jhonatasmoraes/Projeto_TCC_Git/readme.md

Neste projeto será colocado as informações do programa construído para o meu projeto de TCC.

26/02/23 Criação dos arquivos no Git    

-> A
