jhonatasmoraes/Projeto_TCC_Git/Placas/baterias/placa.pdf

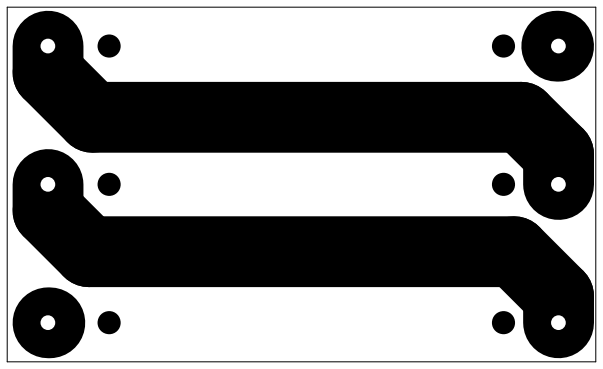
[picture p1: figure]
