jhonatasmoraes/Projeto_TCC_Git/Placas/Base/Chassi2.stl

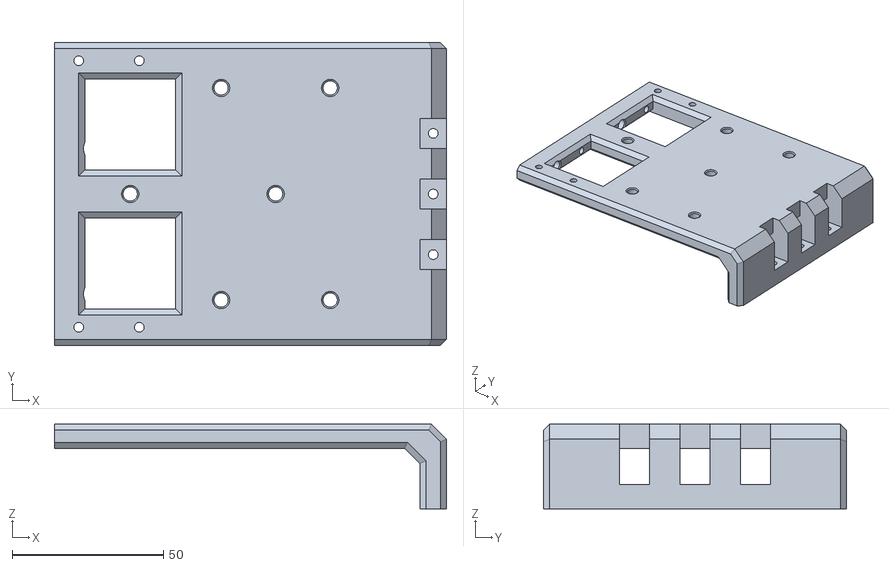
[picture p2: CAD file, 2023-05-03]
Placas/Base/Chassi2.stl
129.4 x 100.0 x 28.0
