jhonatasmoraes/Projeto_TCC_Git/Placas/baterias/baterias.step

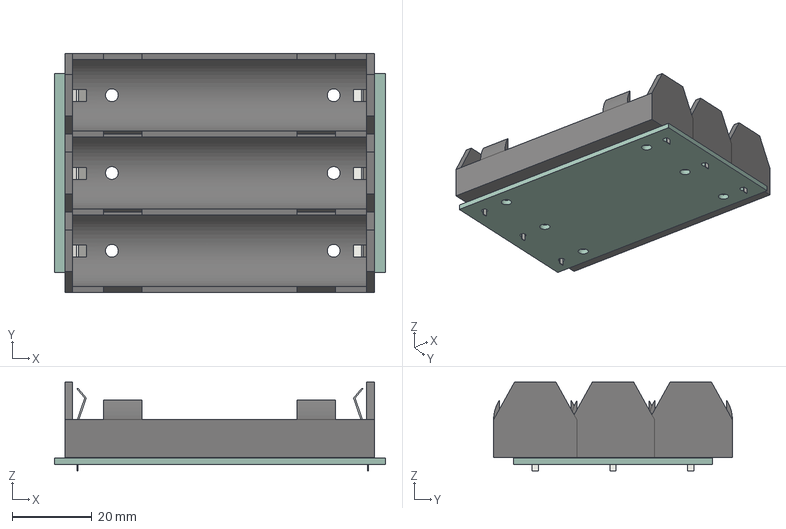
[picture p3: CAD file, 2023-05-03]
Placas/baterias/baterias.step
83.0 x 59.9 x 22.2 mm
baterias PCB
