jhonatasmoraes/Projeto_TCC_Git/Placas/Botoes/botoes/Botao.stl

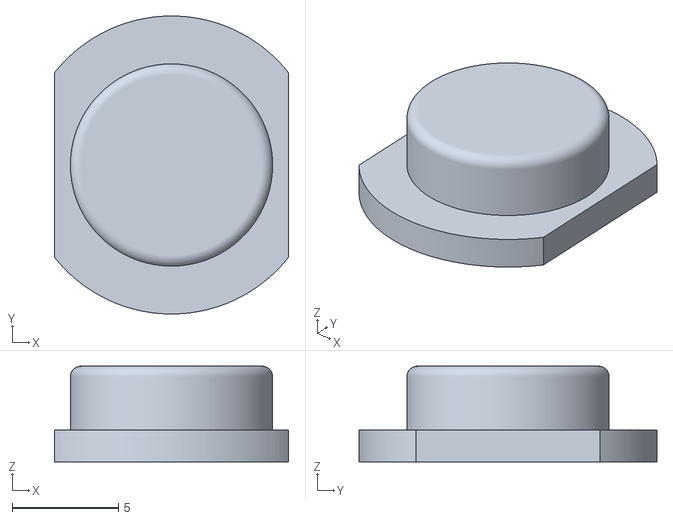
[picture p4: CAD file, 2023-05-03]
Placas/Botoes/botoes/Botao.stl
11.0 x 14.0 x 4.50
