jhonatasmoraes/Projeto_TCC_Git/tampabaseplacas.stl

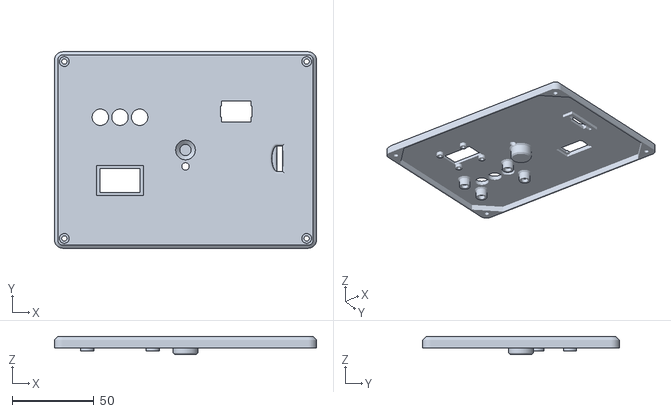
[picture p5: CAD file, 2023-05-03]
tampabaseplacas.stl
160.0 x 120.0 x 11.0
