jhonatasmoraes/Projeto_TCC_Git/ParteFora.stl

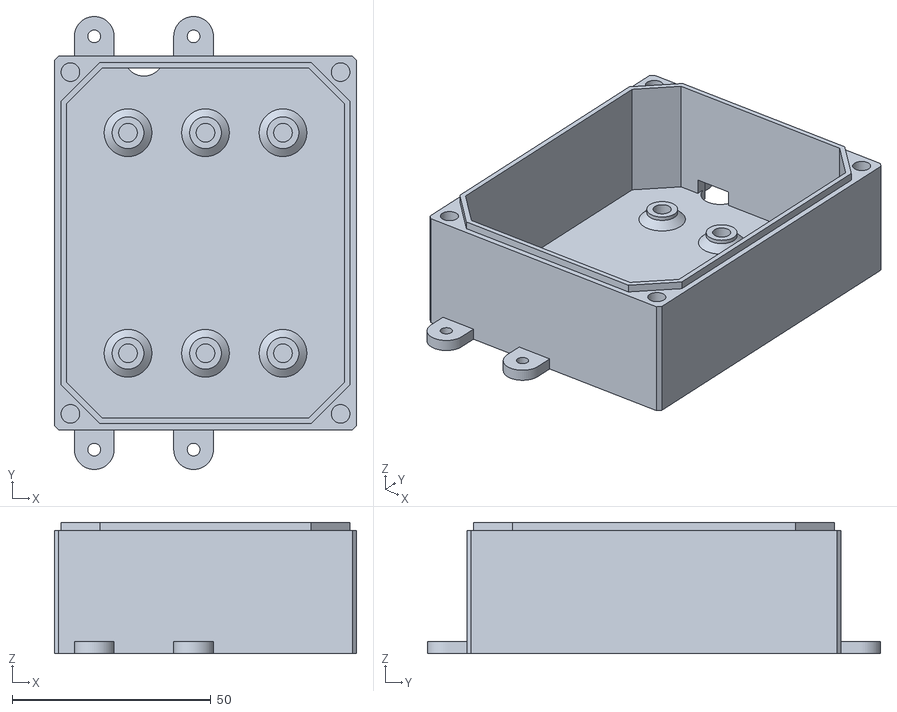
[picture p6: CAD file, 2023-05-03]
ParteFora.stl
76.0 x 114.0 x 33.0
