jhonatasmoraes/Projeto_TCC_Git/Placas/Base/testeinsert.stl

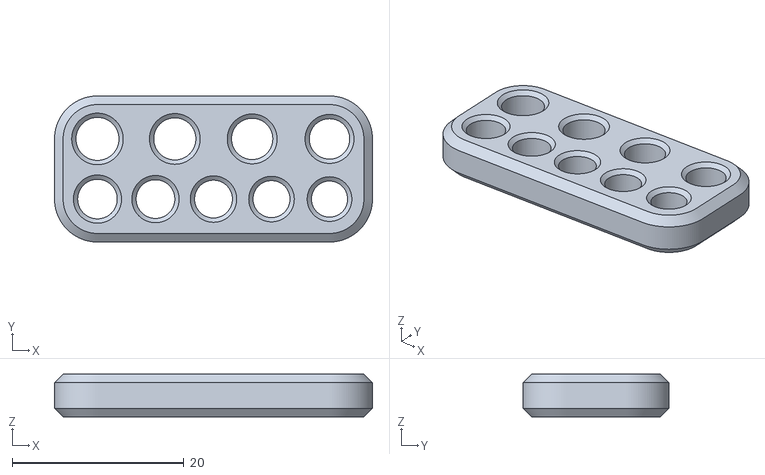
[picture p7: CAD file, 2023-05-03]
Placas/Base/testeinsert.stl
37.0 x 17.0 x 5.00
