jhonatasmoraes/Projeto_TCC_Git/Placas/Botoes/botoes/botoes.step

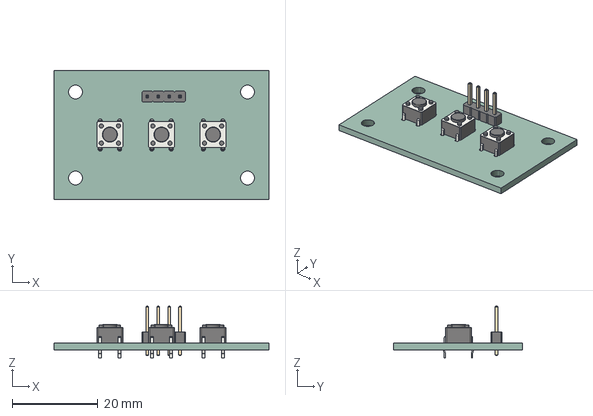
[picture p8: CAD file, 2023-05-03]
Placas/Botoes/botoes/botoes.step
50.0 x 30.0 x 12.0 mm
_autosave-botoes PCB
