jhonatasmoraes/Projeto_TCC_Git/TampaBateria.stl

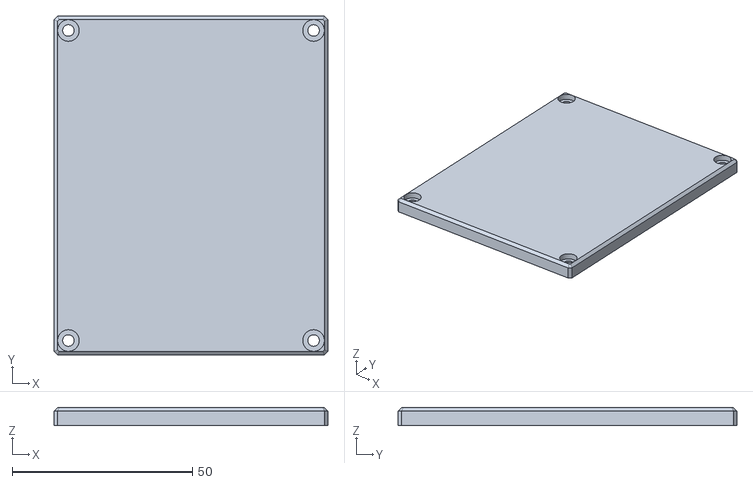
[picture p9: CAD file, 2023-05-03]
TampaBateria.stl
76.0 x 94.0 x 5.00
