jhonatasmoraes/Projeto_TCC_Git/tampa garrafa.stl

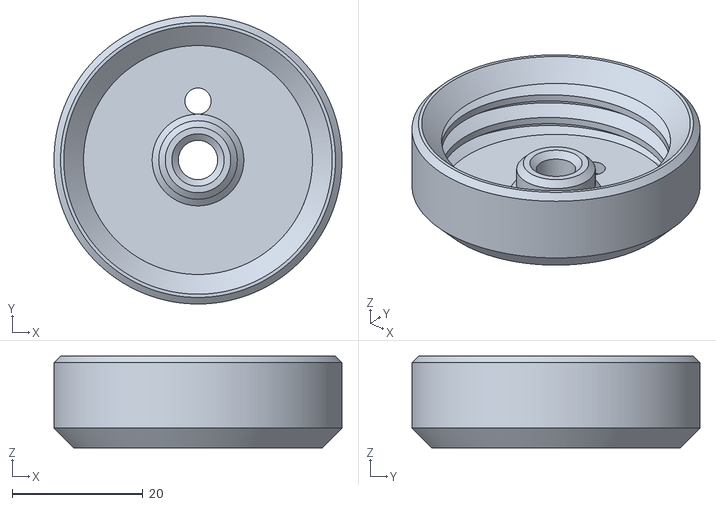
[picture p10: CAD file, 2023-05-03]
tampa garrafa.stl
44.0 x 44.0 x 14.0
