jhonatasmoraes/Projeto_TCC_Git/TravaSuperior.stl

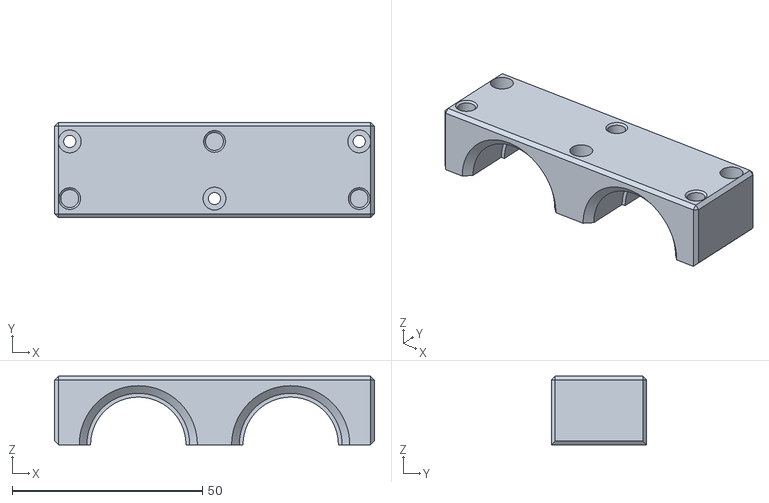
[picture p11: CAD file, 2023-05-03]
TravaSuperior.stl
84.0 x 25.0 x 18.0
