jhonatasmoraes/Projeto_TCC_Git/suporte garrafa.stl

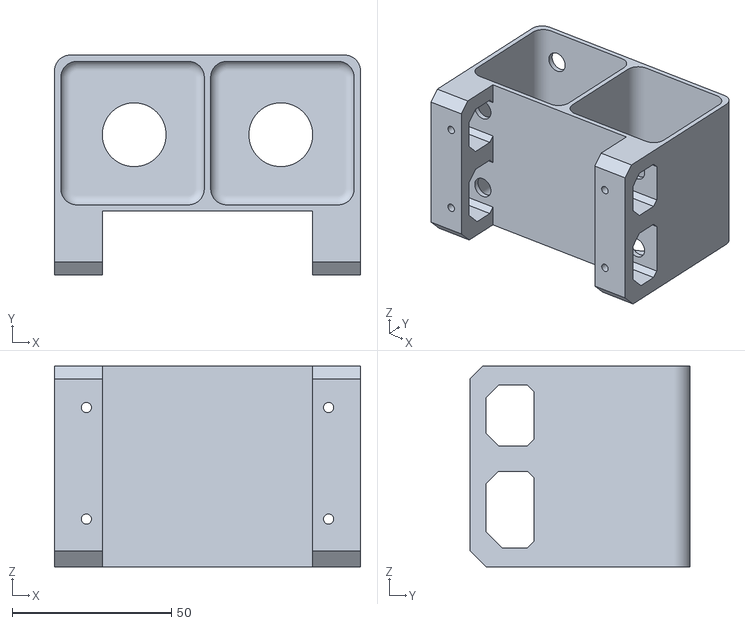
[picture p12: CAD file, 2023-05-03]
suporte garrafa.stl
96.0 x 69.0 x 63.0
