jhonatasmoraes/Projeto_TCC_Git/BombasBase.stl

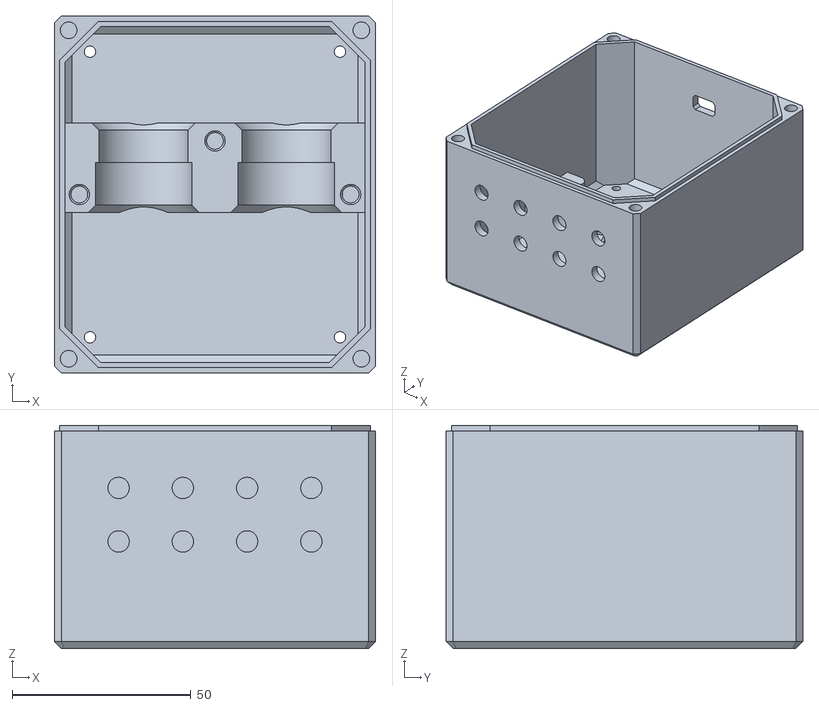
[picture p13: CAD file, 2023-05-03]
BombasBase.stl
90.0 x 100.0 x 62.5
