jhonatasmoraes/Projeto_TCC_Git/botao.stl

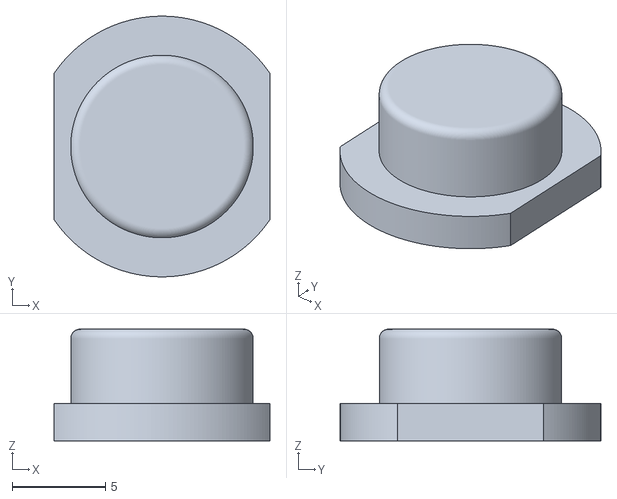
[picture p14: CAD file, 2023-05-03]
botao.stl
11.6 x 14.0 x 6.00
