jhonatasmoraes/Projeto_TCC_Git/Corpo1.stl

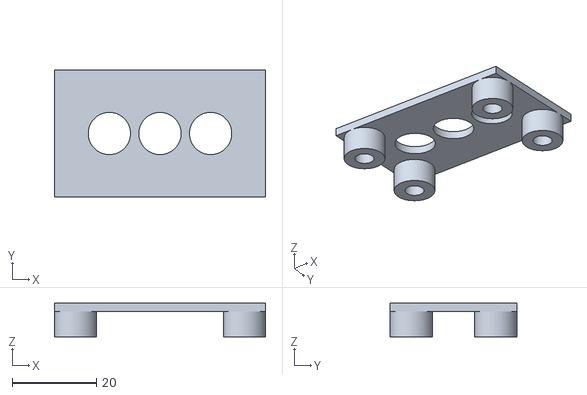
[picture p15: CAD file, 2023-05-03]
Corpo1.stl
50.0 x 30.0 x 8.00
