jhonatasmoraes/Projeto_TCC_Git/BaseBombas.stl

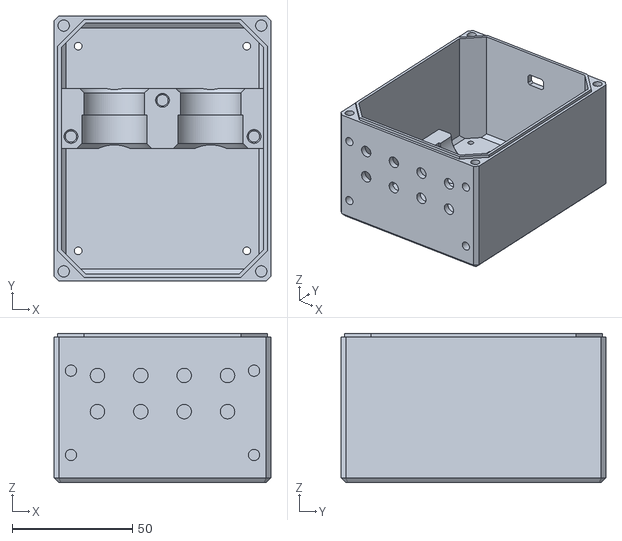
[picture p16: CAD file, 2023-05-03]
BaseBombas.stl
90.0 x 110.0 x 62.0
