jhonatasmoraes/Projeto_TCC_Git/BombasTampa.stl

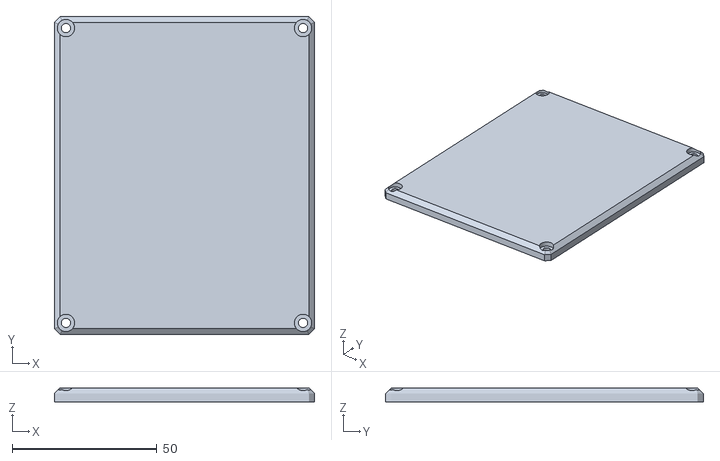
[picture p17: CAD file, 2023-05-03]
BombasTampa.stl
90.0 x 110.0 x 5.00
