jhonatasmoraes/Projeto_TCC_Git/cASEbASE.stl

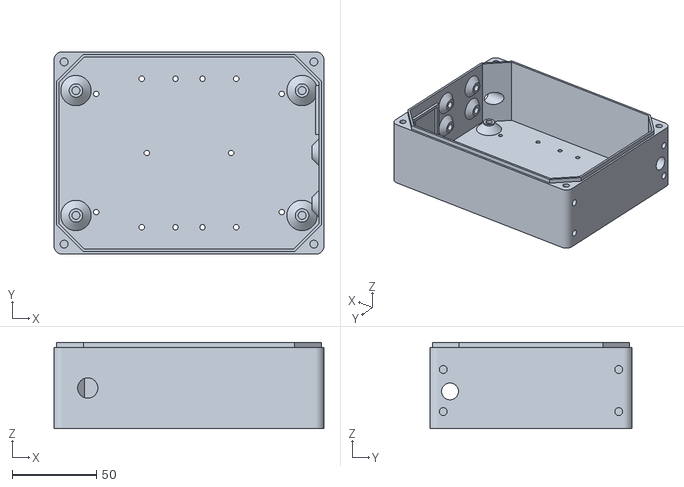
[picture p18: CAD file, 2023-05-03]
cASEbASE.stl
160.0 x 120.0 x 51.0
