jhonatasmoraes/Projeto_TCC_Git/SuportePinoColeta.stl

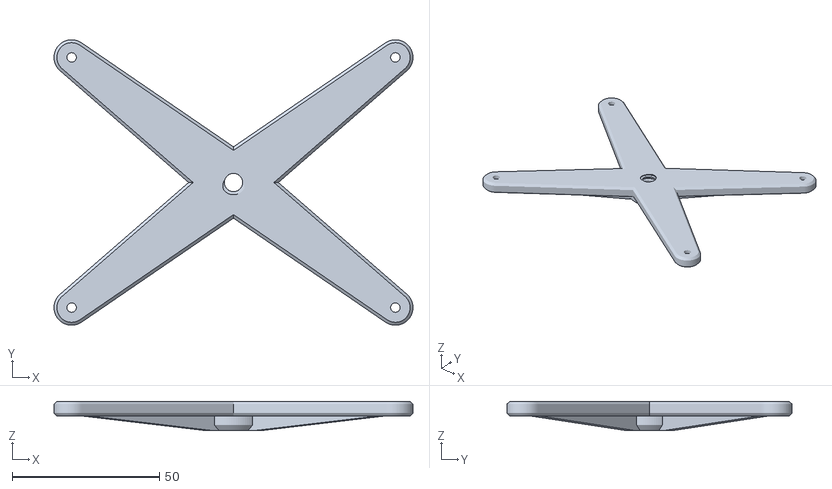
[picture p19: CAD file, 2023-05-03]
SuportePinoColeta.stl
122.0 x 97.0 x 10.0
