jhonatasmoraes/Projeto_TCC_Git/testerosca.stl

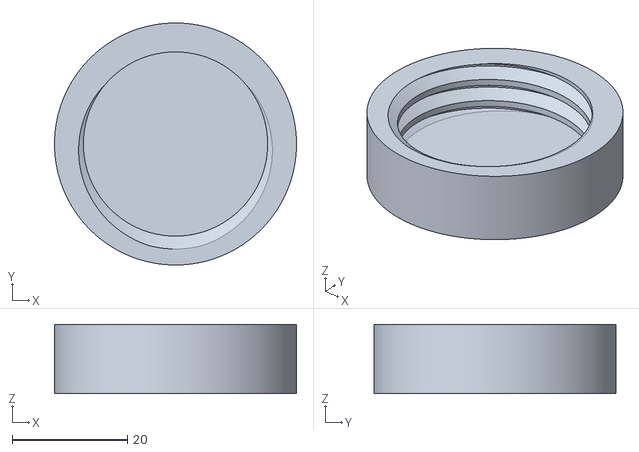
[picture p20: CAD file, 2023-05-03]
testerosca.stl
42.0 x 42.0 x 12.0
