jhonatasmoraes/Projeto_TCC_Git/TravaCentral.stl

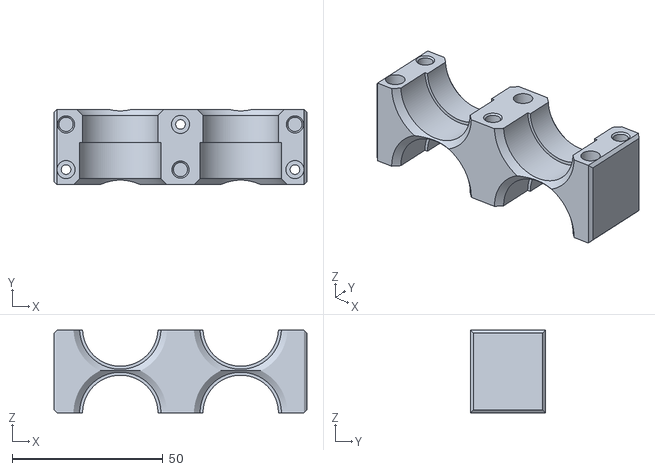
[picture p21: CAD file, 2023-05-03]
TravaCentral.stl
84.0 x 25.0 x 27.5
