jhonatasmoraes/Projeto_TCC_Git/tampateste.stl

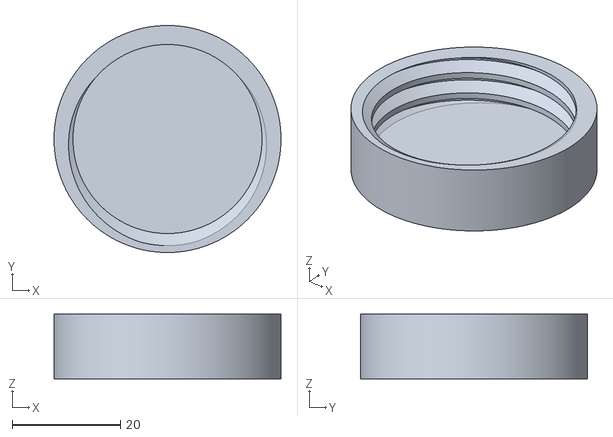
[picture p22: CAD file, 2023-05-03]
tampateste.stl
42.0 x 42.0 x 12.0
