jhonatasmoraes/Projeto_TCC_Git/Emenda.stl

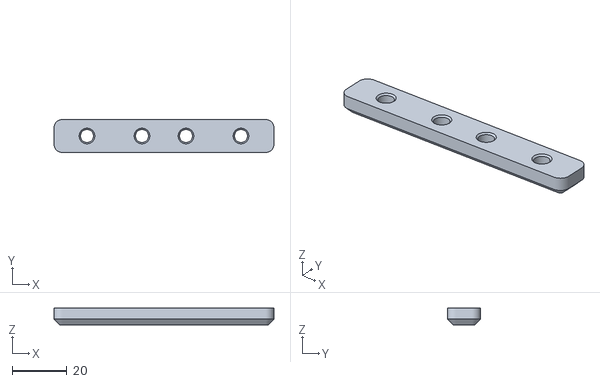
[picture p23: CAD file, 2023-05-03]
Emenda.stl
80.0 x 12.0 x 6.00
