jhonatasmoraes/Projeto_TCC_Git/pinocoleta.stl

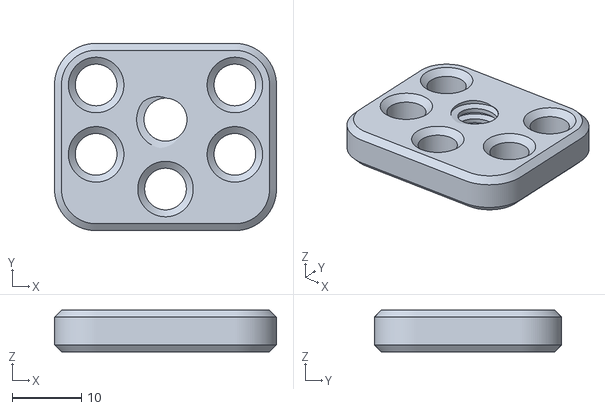
[picture p24: CAD file, 2023-05-03]
pinocoleta.stl
32.0 x 27.0 x 6.00
