jhonatasmoraes/Projeto_TCC_Git/(list of files, cad)

Other CAD files:
tampa.stl
