jhonatasmoraes/Projeto_TCC_Git/Placas/Base/NjczMTEzOTgtMTAz.pdf

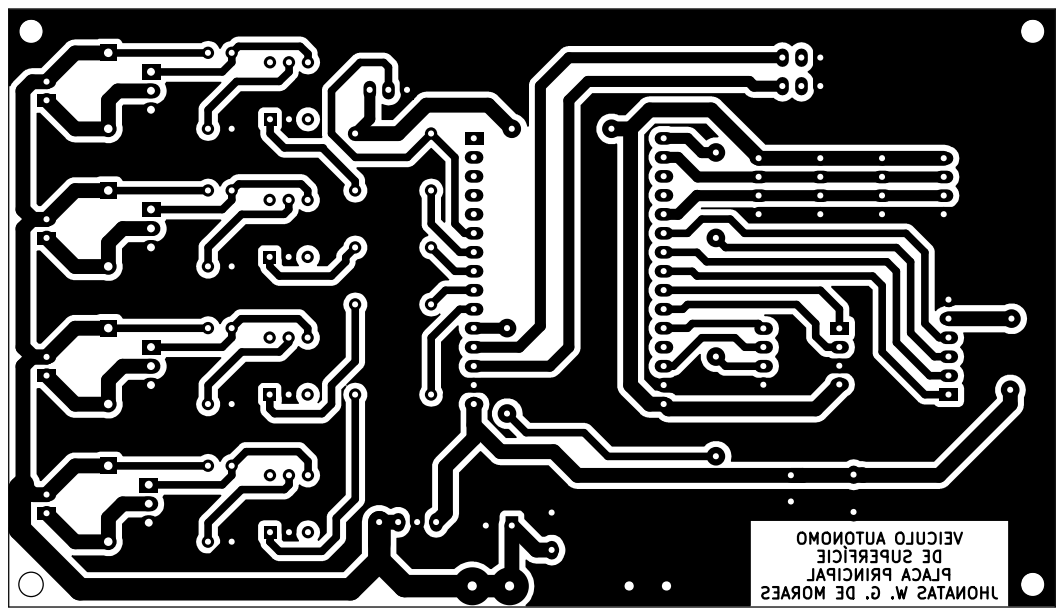
[picture p25: page 1]
