jhonatasmoraes/Projeto_TCC_Git/Placas/Botoes/botoes/asdasdd.pdf

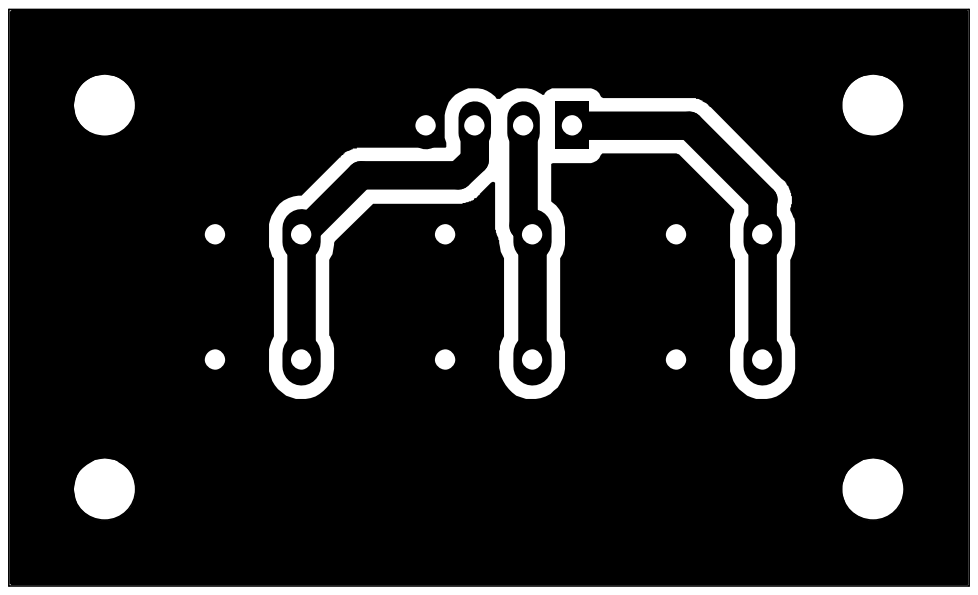
[picture p26: page 1]
