jhonatasmoraes/Projeto_TCC_Git/Placas/Base/Base.kicad_pcb

## KiCad design Placas/Base/Base.kicad_pcb (2023-05-03)

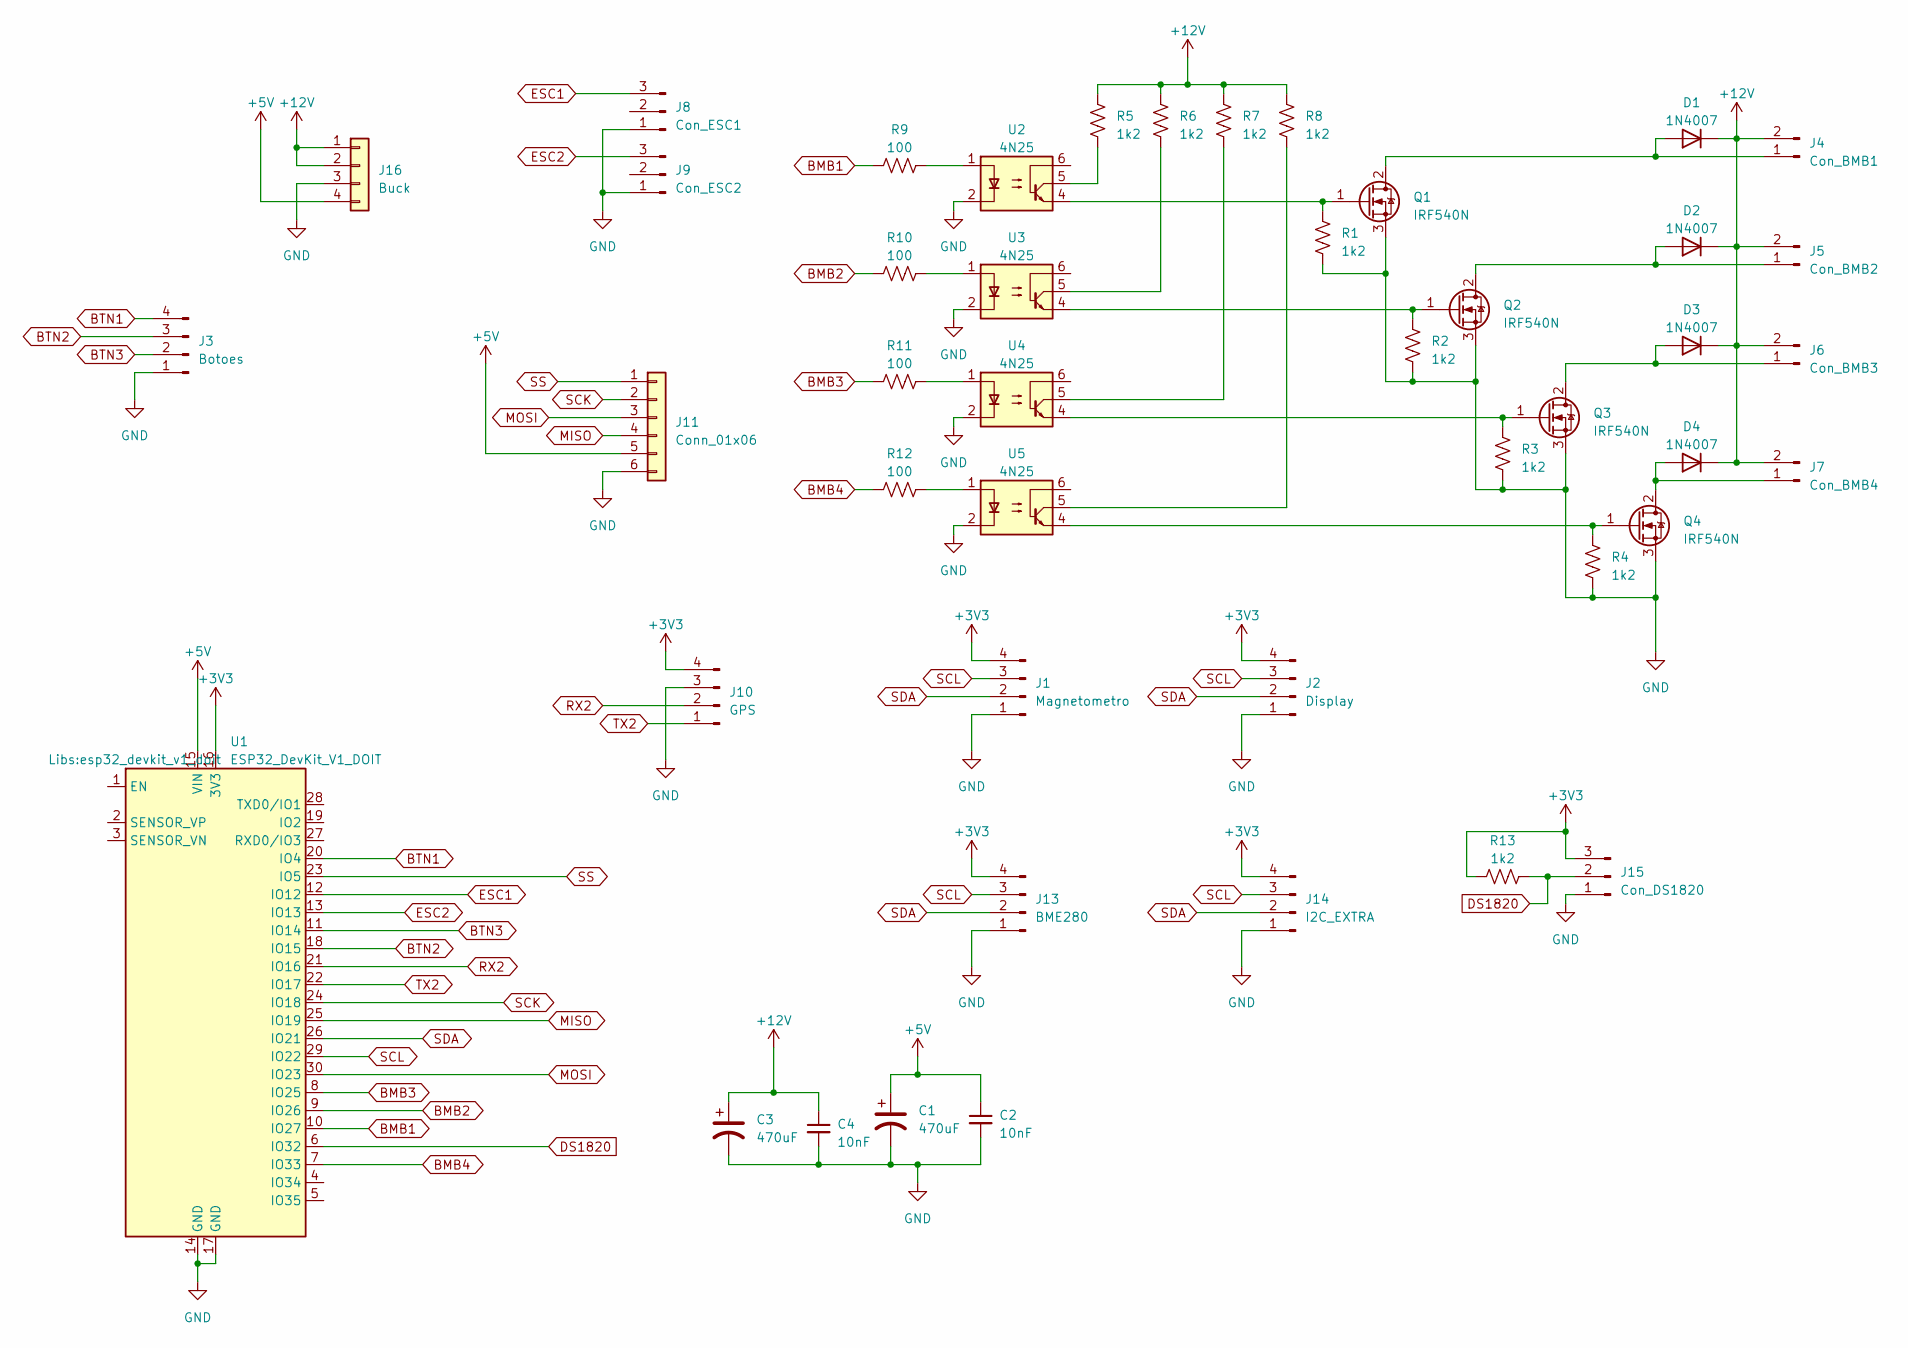
[picture p27: schematic Base.kicad_sch]

Parts:
C1, C3: 470uF; CP_Radial_D8.0mm_P3.50mm
C2, C4: 10nF; C_Disc_D7.0mm_W2.5mm_P5.00mm
D1, D2, D3, D4: 1N4007; D_DO-41_SOD81_P10.16mm_Horizontal
J1: Magnetometro; JST_XH_B4B-XH-A_1x04_P2.50mm_Vertical
J2: Display; JST_XH_B4B-XH-A_1x04_P2.50mm_Vertical
J3: Botoes; JST_XH_B4B-XH-A_1x04_P2.50mm_Vertical
J4: Con_BMB1; JST_XH_B2B-XH-A_1x02_P2.50mm_Vertical
J5: Con_BMB2; JST_XH_B2B-XH-A_1x02_P2.50mm_Vertical
J6: Con_BMB3; JST_XH_B2B-XH-A_1x02_P2.50mm_Vertical
J7: Con_BMB4; JST_XH_B2B-XH-A_1x02_P2.50mm_Vertical
J8: Con_ESC1; PinHeader_1x03_P2.54mm_Vertical
J9: Con_ESC2; PinHeader_1x03_P2.54mm_Vertical
J10: GPS; JST_XH_B4B-XH-A_1x04_P2.50mm_Vertical
J11: Conn_01x06; PinHeader_1x06_P2.54mm_Vertical
J13: BME280; JST_XH_B4B-XH-A_1x04_P2.50mm_Vertical
J14: I2C_EXTRA; JST_XH_B4B-XH-A_1x04_P2.50mm_Vertical
J15: Con_DS1820; JST_XH_B3B-XH-A_1x03_P2.50mm_Vertical
J16: Buck; PinHeader_1x04_P2.54mm_Horizontal
Q1, Q2, Q3, Q4: IRF540N; TO-220-3_Vertical
R1, R2, R3, R4, R5, R6, R7, R8, R13: 1k2; R_Axial_DIN0207_L6.3mm_D2.5mm_P10.16mm_Horizontal
R9, R10, R11, R12: 100; R_Axial_DIN0207_L6.3mm_D2.5mm_P10.16mm_Horizontal
U1: ESP32_DevKit_V1_DOIT; esp32_devkit_v1_doit
U2, U3, U4, U5: 4N25; DIP-6_W7.62mm

Connections:
+3V3: J1.4, J2.4, J10.4, J13.4, J14.4, J15.3, R13.1, U1.16 (3V3)
+5V: C1.1, C2.1, J11.5, J16.4, U1.15 (VIN)
+12V: C3.1, C4.1, D1.1 (K), D2.1 (K), D3.1 (K), D4.1 (K), J4.2, J5.2, J6.2, J7.2, J16.1, J16.2, R5.1, R6.1, R7.1, R8.1
BMB1: R9.1, U1.10 (IO27)
BMB2: R10.1, U1.9 (IO26)
BMB3: R11.1, U1.8 (IO25)
BMB4: R12.1, U1.7 (IO33)
BTN1: J3.4, U1.20 (IO4)
BTN2: J3.3, U1.18 (IO15)
BTN3: J3.2, U1.11 (IO14)
DS1820: J15.2, R13.2, U1.6 (IO32)
ESC1: J8.3, U1.12 (IO12)
ESC2: J9.3, U1.13 (IO13)
GND: C1.2, C2.2, C3.2, C4.2, J1.1, J2.1, J3.1, J8.1, J9.1, J10.3, J11.6, J13.1, J14.1, J15.1, J16.3, Q1.3 (S), Q2.3 (S), Q3.3 (S), Q4.3 (S), R1.2, R2.2, R3.2, R4.2, U1.14 (GND), U1.17 (GND), U2.2, U3.2, U4.2, U5.2
MISO: J11.4, U1.25 (IO19)
MOSI: J11.3, U1.30 (IO23)
unnamed: D1.2 (A), J4.1, Q1.2 (D)
unnamed: D2.2 (A), J5.1, Q2.2 (D)
unnamed: D3.2 (A), J6.1, Q3.2 (D)
unnamed: D4.2 (A), J7.1, Q4.2 (D)
unnamed: Q1.1 (G), R1.1, U2.4
unnamed: Q2.1 (G), R2.1, U3.4
unnamed: Q3.1 (G), R3.1, U4.4
unnamed: Q4.1 (G), R4.1, U5.4
unnamed: R5.2, U2.5
unnamed: R6.2, U3.5
unnamed: R7.2, U4.5
unnamed: R8.2, U5.5
unnamed: R9.2, U2.1
unnamed: R10.2, U3.1
unnamed: R11.2, U4.1
unnamed: R12.2, U5.1
RX2: J10.2, U1.21 (IO16)
SCK: J11.2, U1.24 (IO18)
SCL: J1.3, J2.3, J13.3, J14.3, U1.29 (IO22)
SDA: J1.2, J2.2, J13.2, J14.2, U1.26 (IO21)
SS: J11.1, U1.23 (IO5)
TX2: J10.1, U1.22 (IO17)

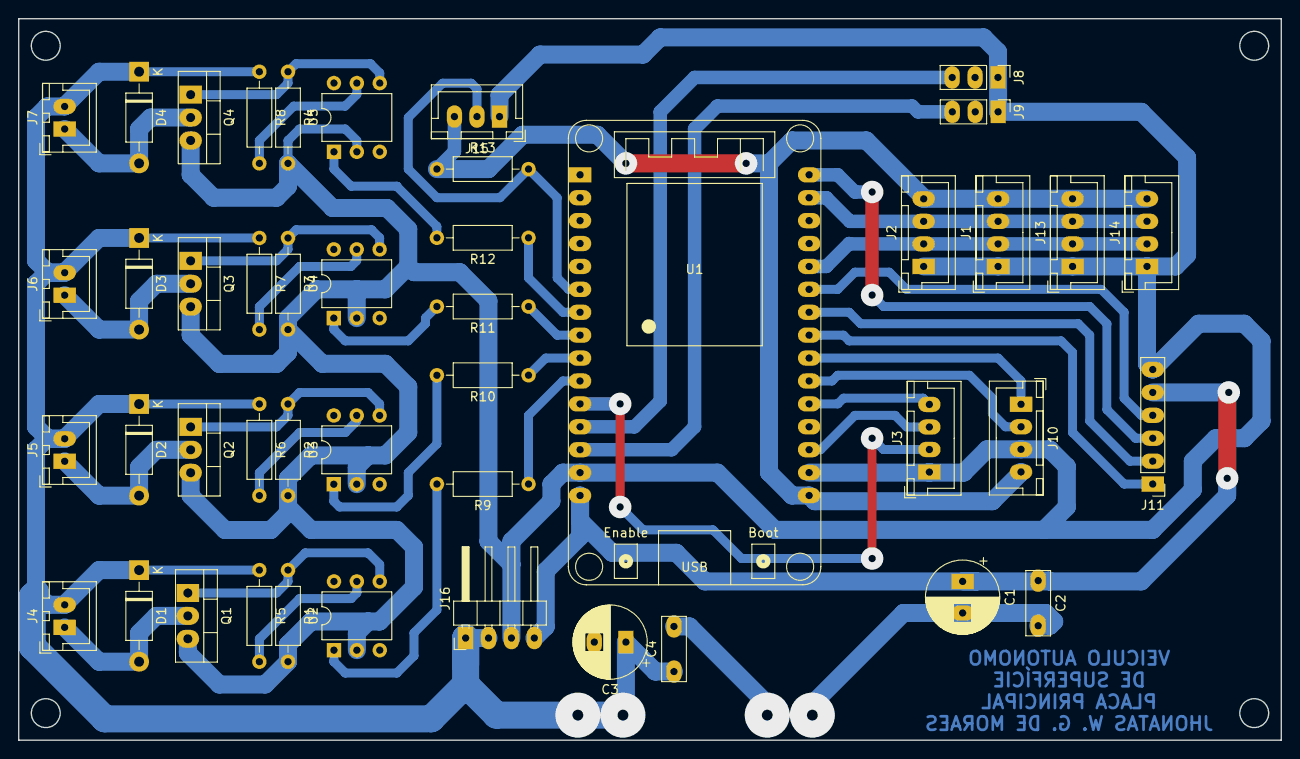
[picture p28: board Base.kicad_pcb from above]

Board: 2 copper layers, 140.0 x 80.0 mm, 45 parts (0 on the bottom side), 38 nets.
