jhonatasmoraes/Projeto_TCC_Git/Placas/Botoes/botoes/botoes.kicad_pcb

## KiCad design Placas/Botoes/botoes/botoes.kicad_pcb (2023-05-03)

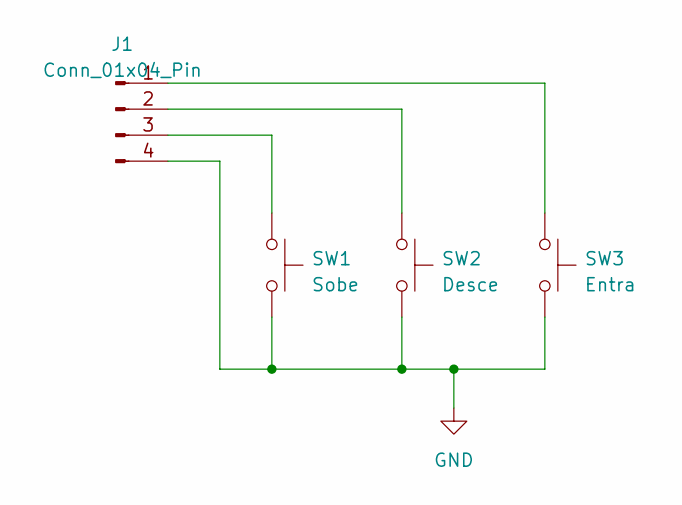
[picture p29: schematic botoes.kicad_sch]

Parts:
J1: Conn_01x04_Pin; PinHeader_1x04_P2.54mm_Vertical
SW1: Sobe; SW_PUSH_6mm
SW2: Desce; SW_PUSH_6mm
SW3: Entra; SW_PUSH_6mm

Connections:
GND: J1.4, SW1.2, SW2.2, SW3.2
unnamed: J1.1, SW3.1
unnamed: J1.2, SW2.1
unnamed: J1.3, SW1.1

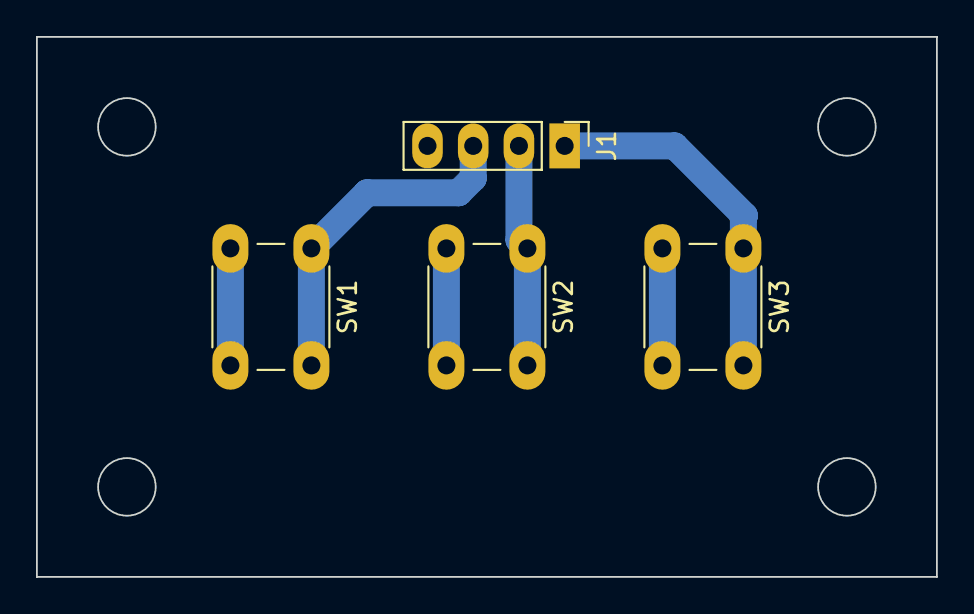
[picture p30: board botoes.kicad_pcb from above]

Board: 2 copper layers, 50.0 x 30.0 mm, 4 parts (0 on the bottom side), 4 nets.
