jhonatasmoraes/Projeto_TCC_Git/Placas/baterias/baterias.kicad_pcb

## KiCad design Placas/baterias/baterias.kicad_pcb (2023-05-03)

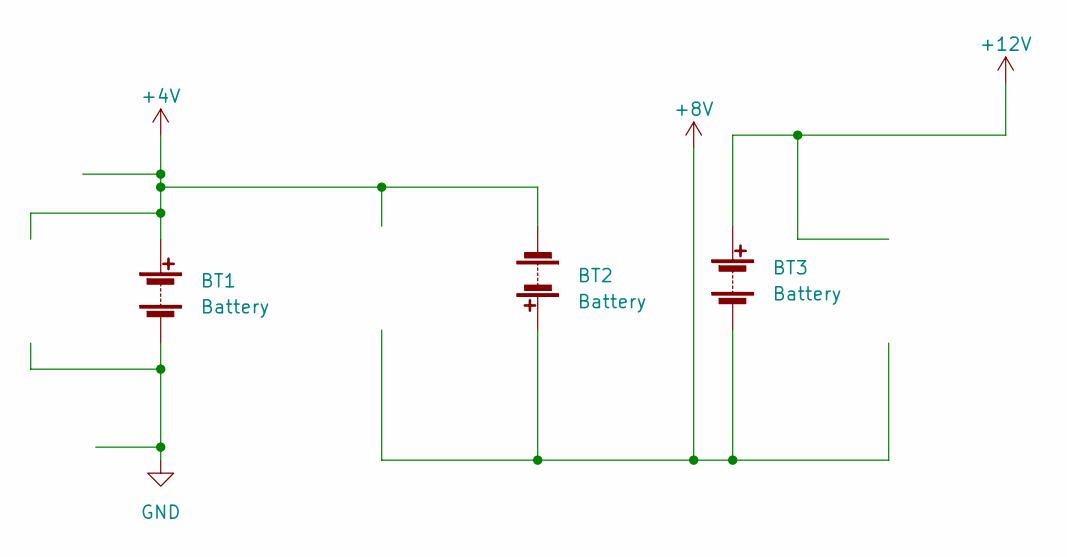
[picture p31: schematic baterias.kicad_sch]

Parts:
BT1, BT2, BT3: Battery; BatteryHolder_MPD_BH-18650-PC2

Connections:
+4V: BT1.1 (+), BT2.2 (-)
+8V: BT2.1 (+), BT3.2 (-)
+12V: BT3.1 (+)
GND: BT1.2 (-)

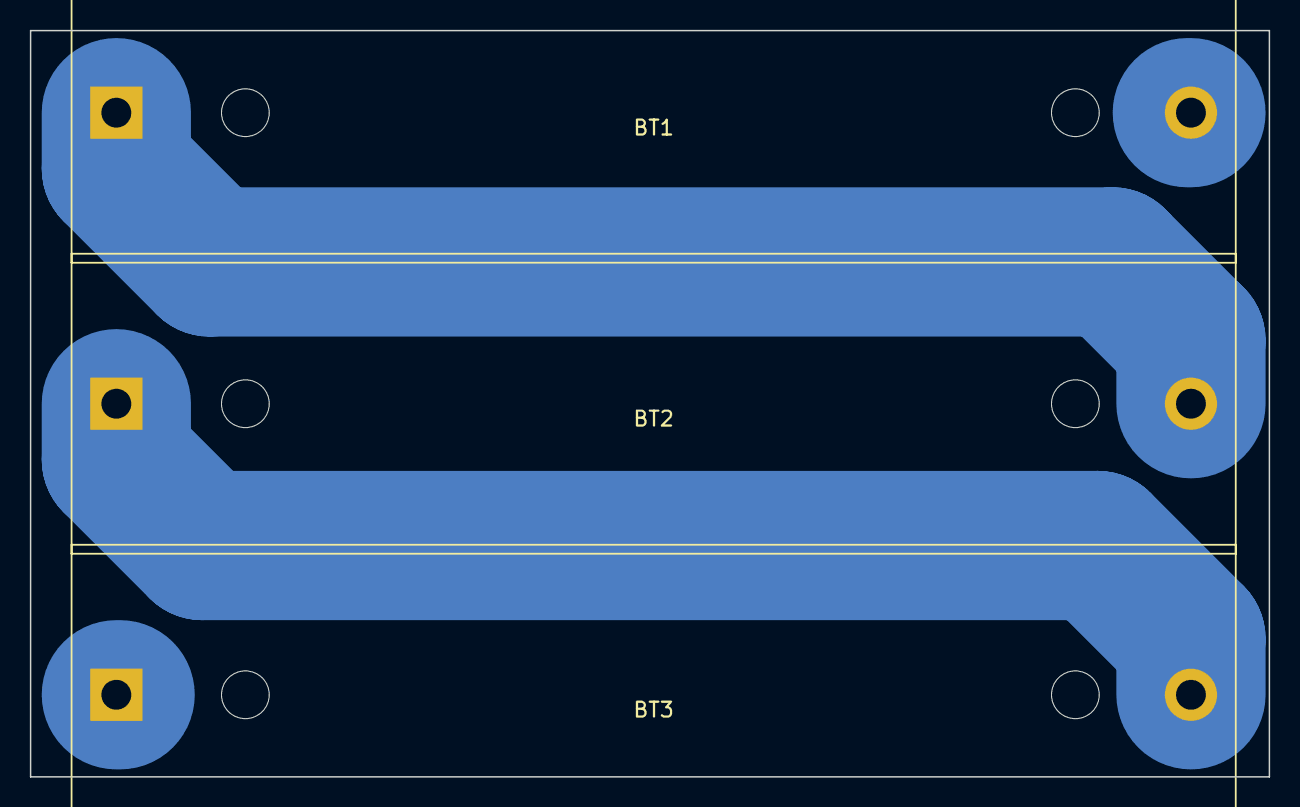
[picture p32: board baterias.kicad_pcb from above]

Board: 2 copper layers, 83.0 x 50.0 mm, 3 parts (0 on the bottom side), 2 nets.
