jhonatasmoraes/Projeto_TCC_Git/VAS_Programa/include/telas_menu.h

// 'StartScreen', 128x64px
const unsigned char epd_bitmap_StartScreen [] PROGMEM = {
	0x00, 0x00, 0x00, 0x00, 0x00, 0x00, 0x00, 0x00, 0x00, 0x00, 0x00, 0x00, 0x00, 0x00, 0x00, 0x00, 
	0x00, 0x00, 0x00, 0x00, 0x00, 0x00, 0x00, 0x00, 0x00, 0x00, 0x00, 0x00, 0x00, 0x00, 0x00, 0x00, 
	0x00, 0x00, 0x00, 0x00, 0x00, 0x00, 0x00, 0x00, 0x00, 0x00, 0x00, 0x00, 0x00, 0x00, 0x00, 0x00, 
	0x00, 0x00, 0x00, 0x00, 0x00, 0x00, 0x00, 0x00, 0x00, 0x00, 0x00, 0x00, 0x00, 0x00, 0x00, 0x00, 
	0x00, 0x00, 0x00, 0x00, 0x00, 0x00, 0x00, 0x00, 0x00, 0x00, 0x00, 0x00, 0x00, 0x00, 0x00, 0x00, 
	0x00, 0x00, 0x00, 0x00, 0x00, 0x00, 0x00, 0x00, 0x00, 0x00, 0x01, 0xc0, 0x00, 0x00, 0x00, 0x00, 
	0x00, 0x00, 0x00, 0x00, 0x00, 0x00, 0x00, 0x00, 0x1c, 0xc0, 0x03, 0x80, 0x00, 0x01, 0xc0, 0x00, 
	0x00, 0x00, 0x00, 0x00, 0x00, 0x00, 0x00, 0x00, 0x1c, 0xc0, 0x00, 0x00, 0x00, 0x01, 0xc0, 0x00, 
	0x00, 0x00, 0x07, 0x00, 0x00, 0x00, 0x00, 0x00, 0x1c, 0xc7, 0xc3, 0x87, 0xc6, 0x71, 0xc3, 0xe0, 
	0x00, 0x00, 0x0b, 0x00, 0x00, 0x00, 0x00, 0x00, 0x1c, 0xce, 0xe3, 0x8e, 0xe6, 0x71, 0xc6, 0x70, 
	0x00, 0x00, 0x0b, 0x80, 0x00, 0x00, 0x00, 0x00, 0x1c, 0xce, 0x63, 0x8c, 0x66, 0x71, 0xc6, 0x70, 
	0x00, 0x00, 0x0b, 0x80, 0x00, 0x00, 0x00, 0x00, 0x1c, 0xcf, 0xe3, 0x8c, 0x06, 0x71, 0xc6, 0x70, 
	0x00, 0x00, 0x0f, 0xc0, 0x00, 0x00, 0x00, 0x00, 0x1c, 0xcf, 0xe3, 0x8c, 0x06, 0x71, 0xc6, 0x70, 
	0x00, 0x00, 0x17, 0x20, 0x00, 0x00, 0x00, 0x00, 0x1d, 0xce, 0x03, 0x8c, 0x06, 0x71, 0xc6, 0x70, 
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
	0x40, 0x00, 0x00, 0x00, 0x00, 0x00, 0x00, 0x00, 0x00, 0x00, 0x00, 0x00, 0x00, 0x00, 0x01, 0x80, 
	0x20, 0x00, 0x00, 0x00, 0x00, 0x00, 0x00, 0x00, 0x00, 0x00, 0x00, 0x00, 0x00, 0x00, 0x01, 0x80, 
	0x1f, 0xff, 0xff, 0xff, 0xff, 0xff, 0xff, 0xff, 0xff, 0xff, 0xff, 0xff, 0xff, 0xff, 0xff, 0x00, 
	0x0f, 0xff, 0xff, 0xff, 0xff, 0xff, 0xff, 0xff, 0xff, 0xff, 0xff, 0xff, 0xff, 0xff, 0xfe, 0x00
};
