jhonatasmoraes/Projeto_TCC_Git/(commit log)

2023-02-26 Teste de atualização do arquivo
2023-02-26 Adicionado o desvio magnetico para os testes
2023-02-26 Adicionadas mais bibliotecas e problemas com magnetometro
    [main.cpp]
2023-03-02 Adicionado a correção de calibração magnetometro e pré adicionado os botoes
2023-03-19 adicionado os comandos de ESC
2023-04-02 Adicionado a leitura de dados do cartão SD e adicionado alguns comentarios
2023-04-02 Adicionado o espaço para a função navegar e separadores
2023-05-03 Update antes das demais mudanças 03-05-23
    [Base.kicad_pcb, Base.kicad_sch, BaseBombas.stl, BombasBase.stl, BombasTampa.stl, Botao.stl, Chassi2.stl, Corpo1.stl]
